AnasSarkiz/NEMA14_RP2040_V2/artifacts/v2/assembly/assembly-pcb.png

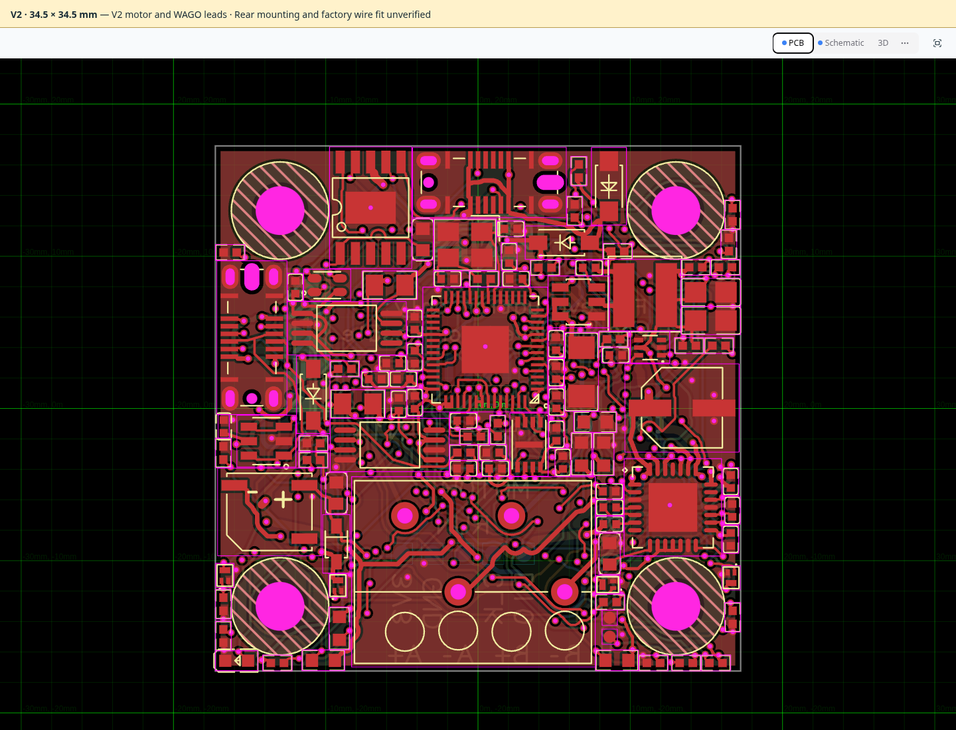
artifacts/v2/assembly/assembly-pcb.png
