AnasSarkiz/NEMA14_RP2040_V2/artifacts/v2/model-hosting/photorealistic-angled.png

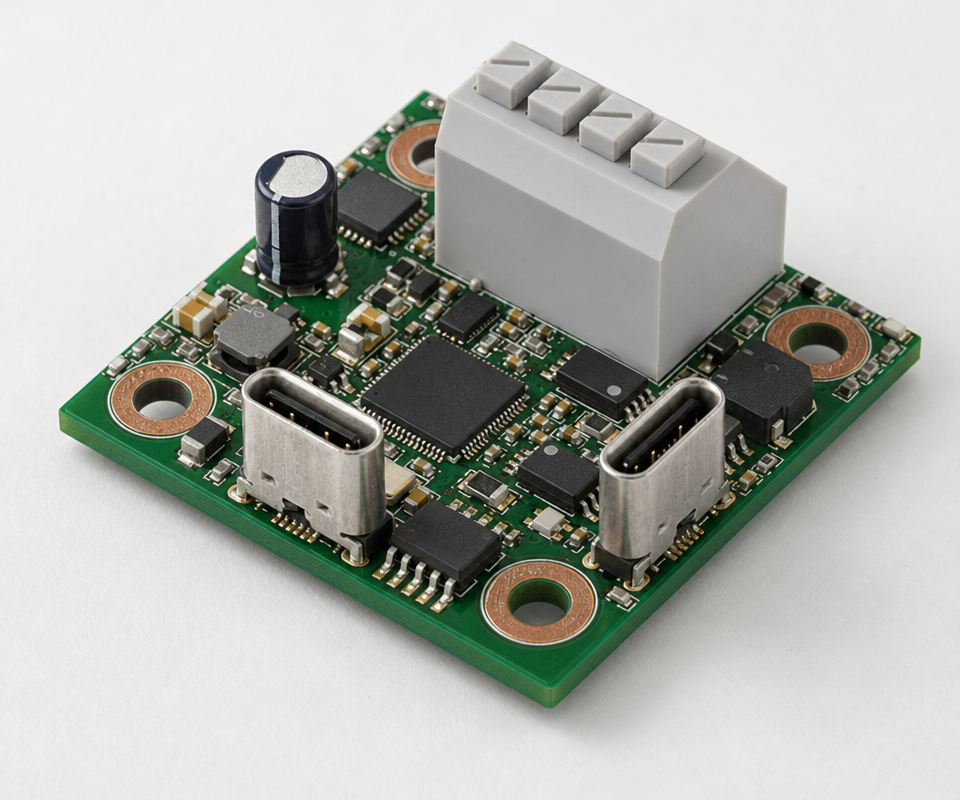
artifacts/v2/model-hosting/photorealistic-angled.png
