AnasSarkiz/NEMA14_RP2040_V2/artifacts/v2/placement.png

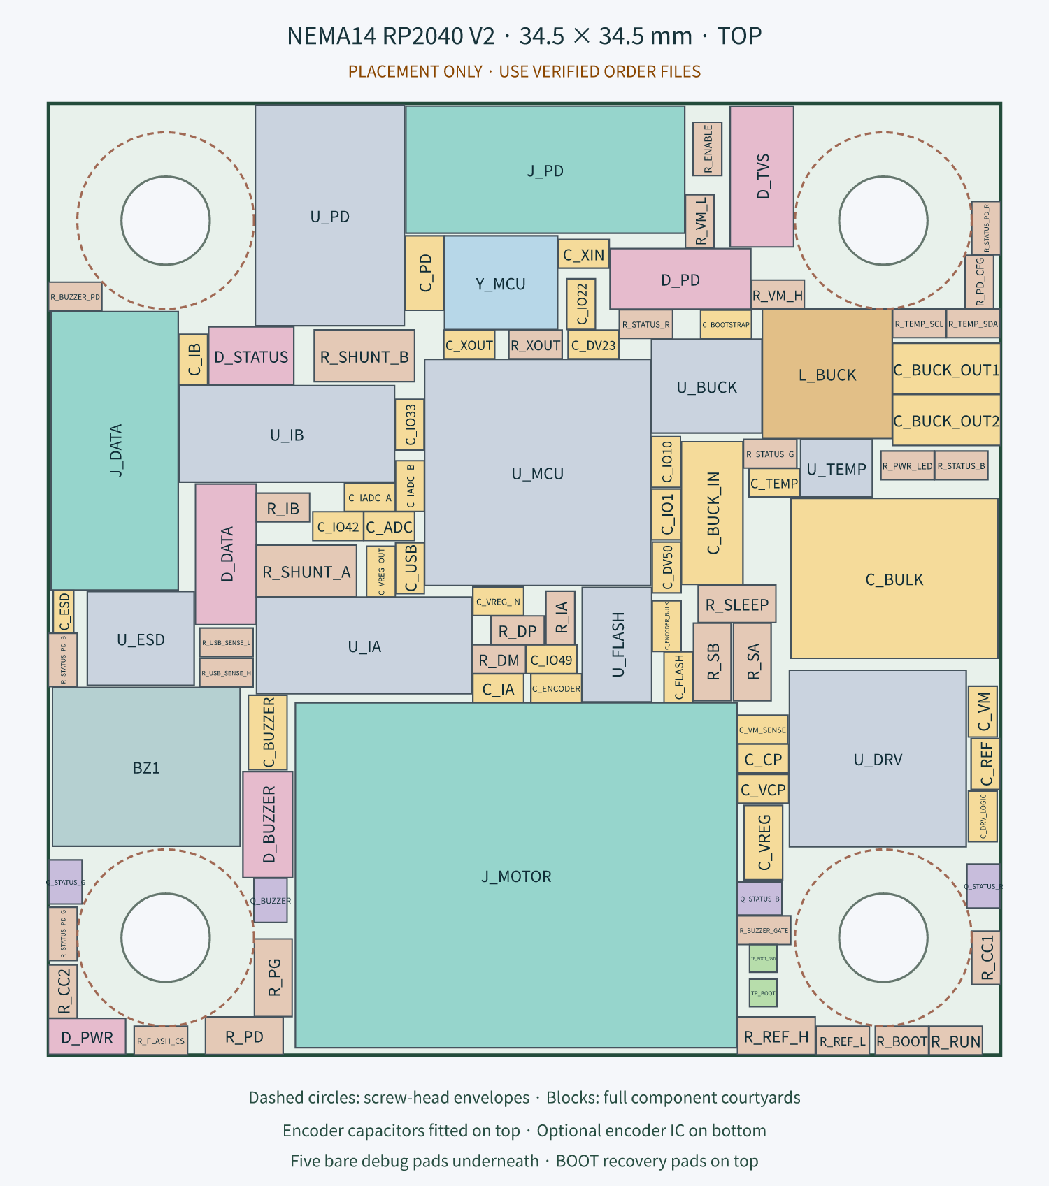
artifacts/v2/placement.png
