AnasSarkiz/NEMA14_RP2040_V2/artifacts/v2/routing/full-bottom-silkscreen.png

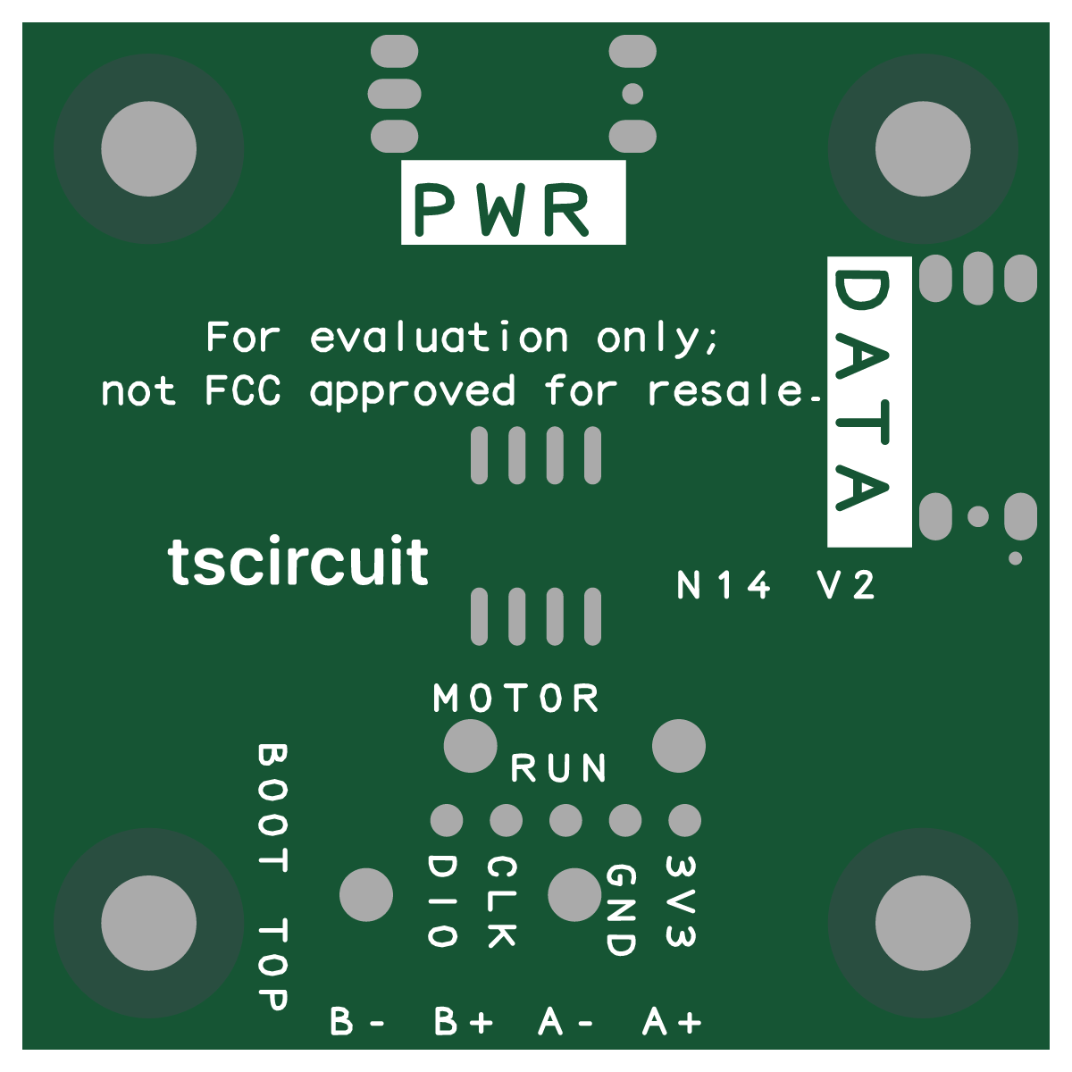
artifacts/v2/routing/full-bottom-silkscreen.png
