AnasSarkiz/NEMA14_RP2040_V2/artifacts/v2/routing/inner1.png

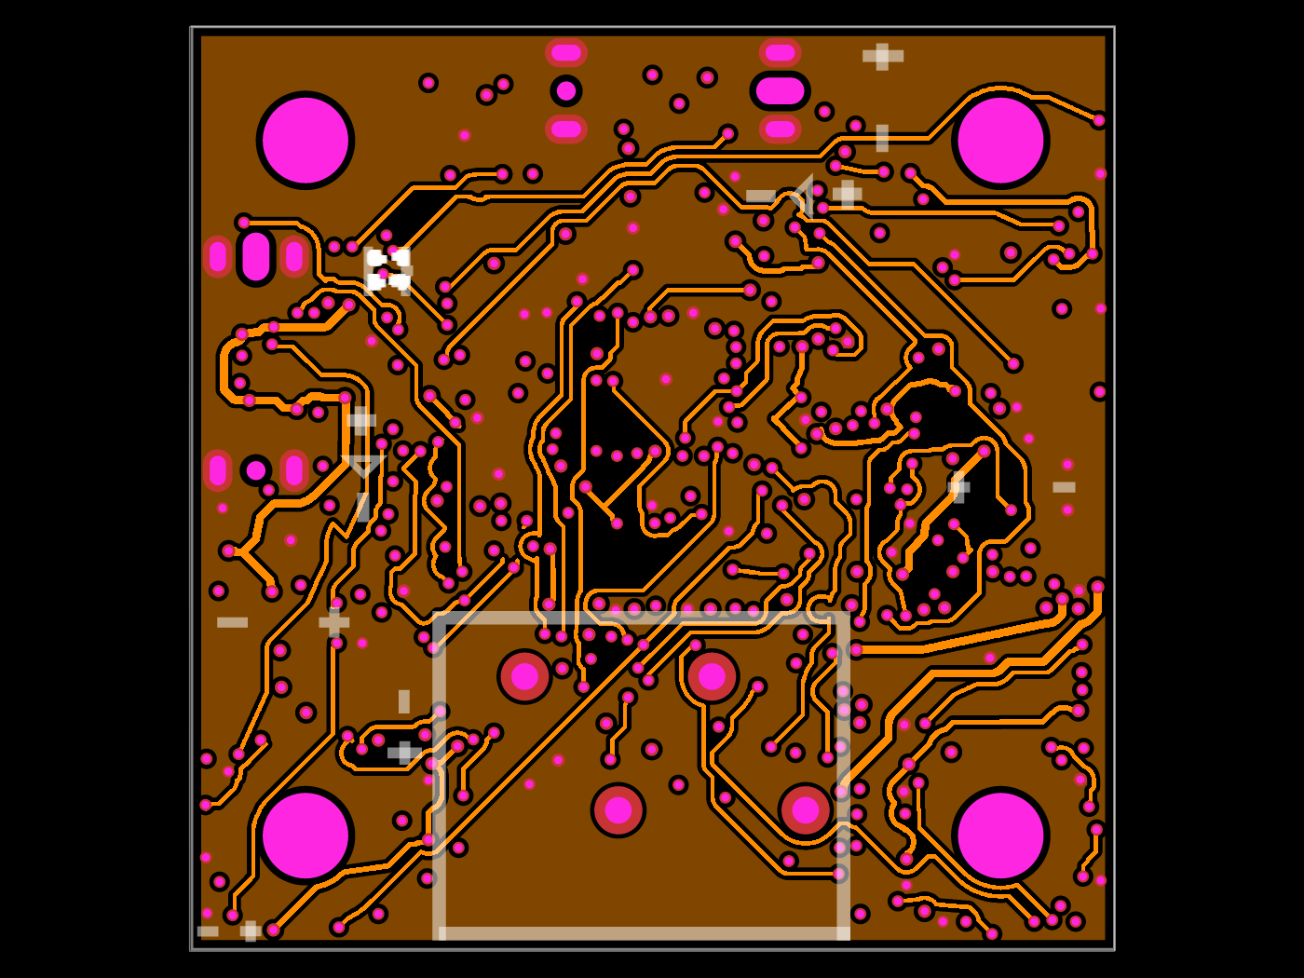
artifacts/v2/routing/inner1.png
