AnasSarkiz/NEMA14_RP2040_V2/artifacts/v2/routing/top.png

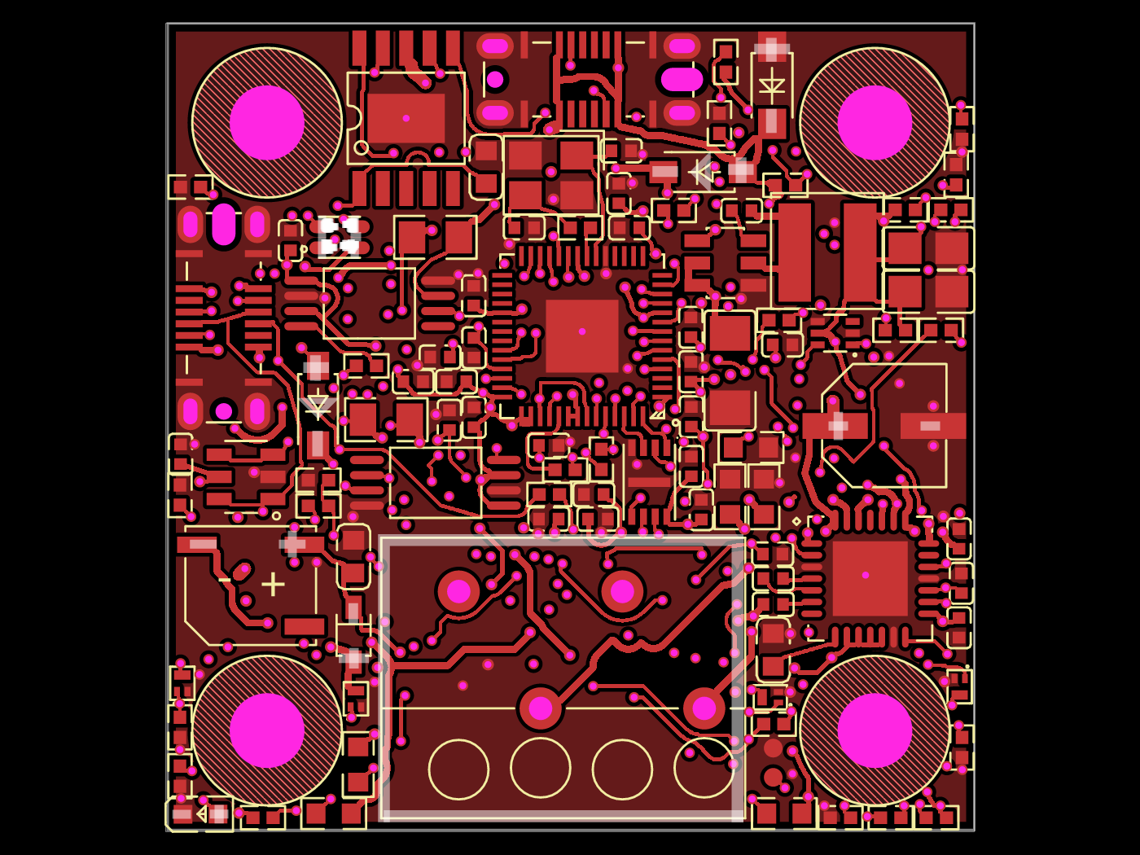
artifacts/v2/routing/top.png
