AnasSarkiz/NEMA14_RP2040_V2/artifacts/v2/routing/viewer-pcb.png

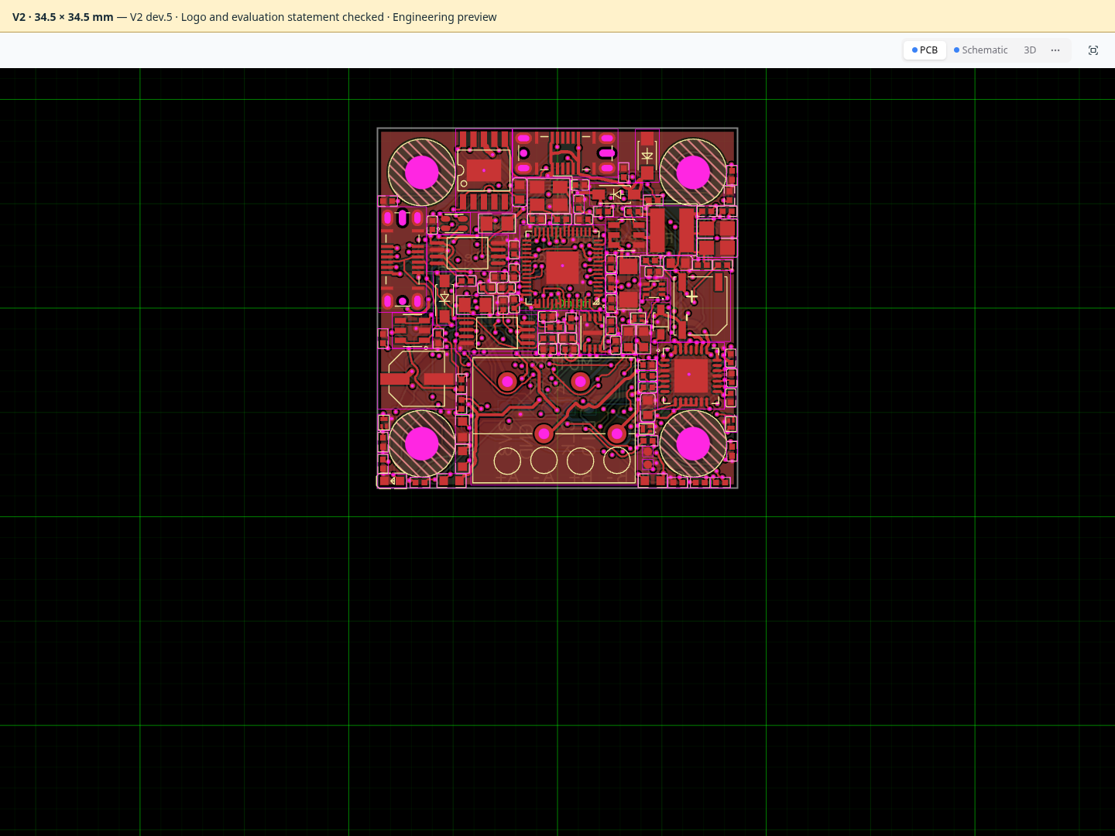
artifacts/v2/routing/viewer-pcb.png
