AnasSarkiz/NEMA14_RP2040_V2/artifacts/v2/order-review/NEMA14_RP2040_V2-BOM.csv

Comment | Designator | Footprint | LCSC Part #
USB4145-03-0070-C | J_PD,J_DATA | C5815189 | C5815189
CH224A | U_PD | C42459160 | C42459160
0603WAF0000T5E | R_PD | C21189 | C21189
CL10A105KB8NNNC | C_PD | C15849 | C15849
0603WAF1002T5E | R_PG,R_SLEEP | C25804 | C25804
RP2040 | U_MCU | C2040 | C2040
CL05B104KO5NNNC | C_IO1,C_IO10,C_IO22,C_IO33,C_IO42,C_IO49,C_DV23,C_DV50,C_USB,C_ADC,C_FLASH,C_BOOTSTRAP,C_DRV_LOGIC,C_IA,C_IB,C_TEMP,C_ENCODER,C_ESD | C1525 | C1525
CL05A105KA5NQNC | C_VREG_IN,C_VREG_OUT,C_ENCODER_BULK | C52923 | C52923
GD25Q16EEIGR | U_FLASH | C2986331 | C2986331
0402WGF1002TCE | R_FLASH_CS,R_RUN,R_VM_L,R_REF_L,R_ENABLE,R_STATUS_PD_R,R_STATUS_PD_G,R_STATUS_PD_B | C25744 | C25744
0402WGF1001TCE | R_BOOT,R_XOUT,R_STATUS_R,R_STATUS_G,R_STATUS_B | C11702 | C11702
ABM8-272-T3 | Y_MCU | C20625731 | C20625731
0402CG150J500NT | C_XIN,C_XOUT | C1548 | C1548
0402WGF270JTCE | R_DM,R_DP | C25100 | C25100
0402WGF5101TCE | R_CC1,R_CC2 | C25905 | C25905
0402WGF1003TCE | R_USB_SENSE_H,R_USB_SENSE_L,R_VM_H,R_BUZZER_PD | C25741 | C25741
CL05B103KB5NNNC | C_VM_SENSE,C_IADC_A,C_IADC_B,C_REF | C15195 | C15195
AP63203WU-7 | U_BUCK | C780769 | C780769
SRN4018-4R7M | L_BUCK | C780206 | C780206
CL31A106KBHNNNE | C_BUCK_IN | C13585 | C13585
CL21A226MAQNNNE | C_BUCK_OUT1,C_BUCK_OUT2 | C45783 | C45783
B5819W SL | D_PD,D_DATA | C8598 | C8598
A4988SETTR-T | U_DRV | C38437 | C38437
CL05B104KB5NNNC | C_CP,C_VCP,C_VM | C960916 | C960916
CL10B224KA8NNNC | C_VREG | C21120 | C21120
EEEFT1V470AR | C_BULK | C193627 | C193627
SR731JTTDR240F | R_SA,R_SB | C186557 | C186557
ERJL06KF50MV | R_SHUNT_A,R_SHUNT_B | C713441 | C713441
INA240A1PWR | U_IA,U_IB | C93965 | C93965
0402WGF1000TCE | R_IA,R_IB,R_BUZZER_GATE | C25076 | C25076
0603WAF3902T5E | R_REF_H | C23153 | C23153
250-204 | J_MOTOR | C2765063 | C2765063
USBLC6-2SC6 | U_ESD | C2687116 | C2687116
SMF18A | D_TVS | C19077512 | C19077512
TMP102AIDRLR | U_TEMP | C99269 | C99269
0402WGF4701TCE | R_TEMP_SDA,R_TEMP_SCL | C25900 | C25900
XL-1608SURC-06 | D_PWR | C965799 | C965799
0402WGF3300TCE | R_PWR_LED | C25104 | C25104
LTST-C19HE1WT | D_STATUS | C458749 | C458749
DMN2300UFB4-7B | Q_STATUS_R,Q_STATUS_G,Q_STATUS_B,Q_BUZZER | C154728 | C154728
MLT-5020 | BZ1 | C94598 | C94598
B5819WS | D_BUZZER | C64886 | C64886
CL10A106KP8NNNC | C_BUZZER | C19702 | C19702
0402WGF5602TCE | R_PD_CFG | C25796 | C25796
