AnasSarkiz/NEMA14_RP2040_V2/artifacts/v2/order-review/cam/independent-render/In1_Cu.png

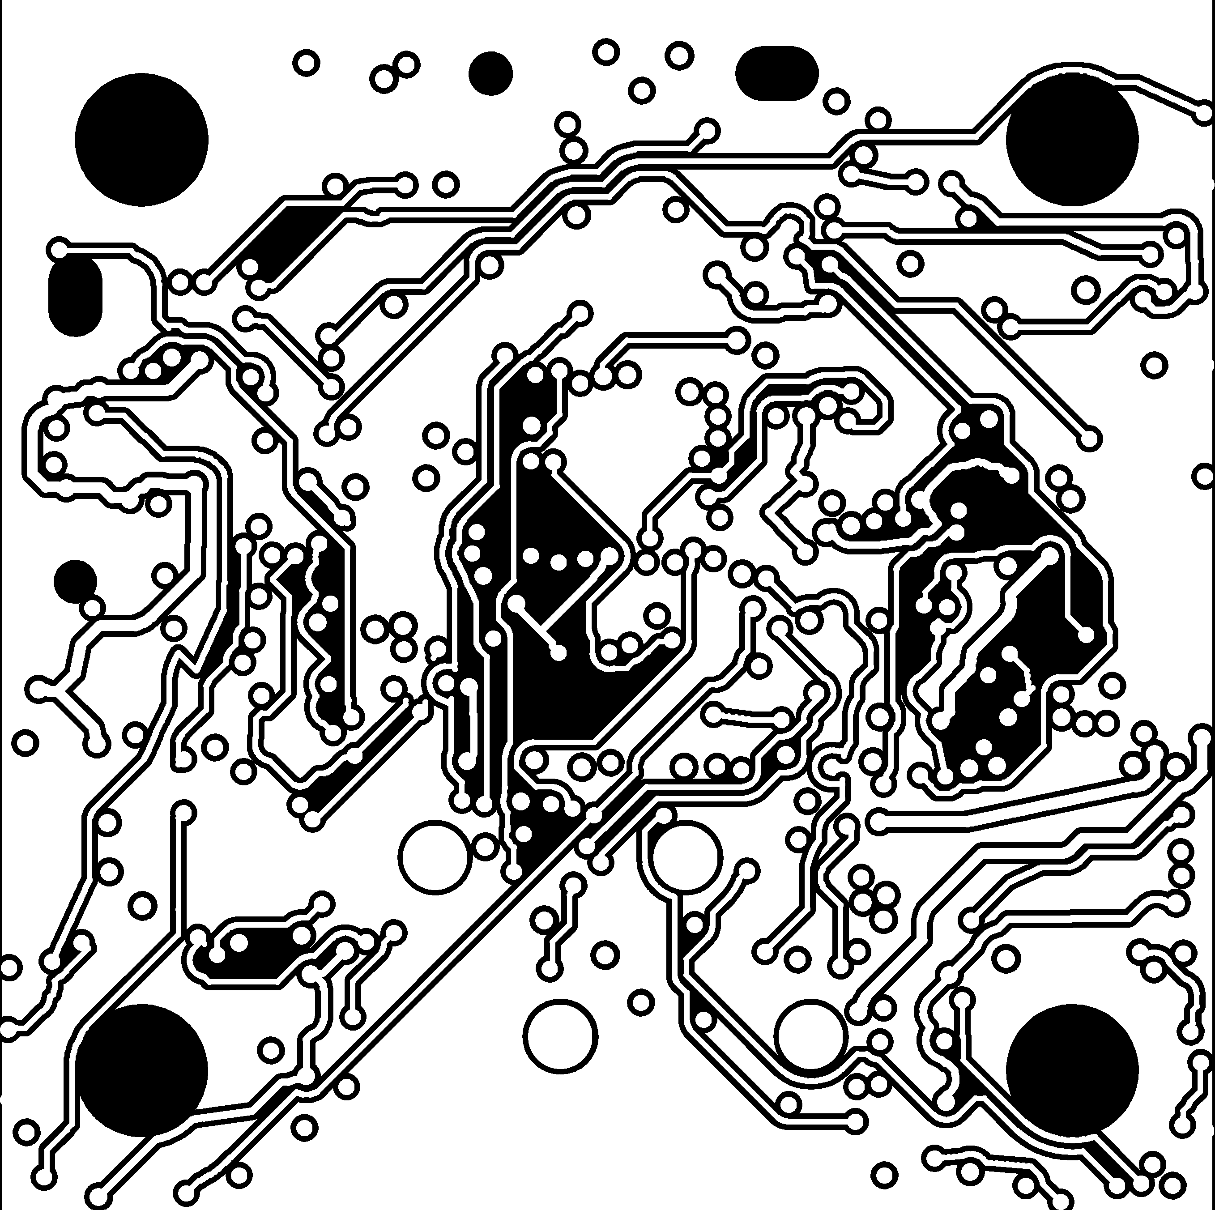
artifacts/v2/order-review/cam/independent-render/In1_Cu.png
