AnasSarkiz/NEMA14_RP2040_V2/(commit log)

2026-11-03 Preserve source advisories while checking native PCB DRC for publication
2026-11-03 Fix USB locating-slot rotation with latest tscircuit reimport and add repro
    [diagnostic-npth-not-for-order.drl, slot-rotation-probe.drl]
2026-11-03 Record verified dev.2 publication with corrected USB drill orientation
2026-11-03 Fix V2 source analysis definitions and verify unchanged routing
    [diagnostic-npth-not-for-order.drl]
2026-11-03 Make essential V2 wiring and debug legends readable
    [diagnostic-npth-not-for-order.drl]
2026-11-03 Record verified dev.4 silkscreen preview publication
2026-11-03 Restore V2 branding and add native motor with direct WAGO leads
    [diagnostic-npth-not-for-order.drl]
2026-11-03 Record verified dev.5 assembly publication and native viewer images
2026-11-03 Shorten motor leads with compact smooth bends into WAGO terminal
    [check-v2-wire-shape.py, publish-v2-tscircuit.py]
2026-11-03 Record verified dev.6 compact wire assembly publication
2026-11-03 Add separate clear-cover and motor-carrier enclosure concept
    [grip_front_left.step, grip_front_left.stl, grip_front_right.step, grip_front_right.stl, grip_left.step, grip_left.stl, grip_rear.step, grip_rear.stl]
2026-11-03 Record separate enclosure preview publication without changing approved defaults
2026-11-03 Revert enclosure concept and restore approved dev.6 project
    [grip_front_left.step, grip_front_left.stl, grip_front_right.step, grip_front_right.stl, grip_left.step, grip_left.stl, grip_rear.step, grip_rear.stl]
2026-11-03 Prepare V2 prototype CAM and fix local driver bulk placement
    [B_Cu.gbr, B_Mask.gbr, B_Paste.gbr, B_SilkScreen.gbr, Edge_Cuts.gbr, F_Cu.gbr, F_Fab.gbr, F_Mask.gbr]
2026-11-04 fix: strengthen V2 driver defaults and add local USB ESD bypass
    [B_Cu.gbr, B_Mask.gbr, Edge_Cuts.gbr, F_Cu.gbr, F_Fab.gbr, F_Mask.gbr, F_Paste.gbr, F_SilkScreen.gbr]
2026-11-04 Enlarge bottom USB port legends as knockout silkscreen
    [B_Cu.gbr, B_Mask.gbr, B_SilkScreen.gbr, Edge_Cuts.gbr, F_Cu.gbr, F_Fab.gbr, F_Mask.gbr, In1_Cu.gbr]
2026-11-04 Move bottom tscircuit wordmark into empty underside space
    [B_Cu.gbr, B_Mask.gbr, B_SilkScreen.gbr, Edge_Cuts.gbr, F_Cu.gbr, F_Fab.gbr, F_Mask.gbr, In1_Cu.gbr]
2026-11-06 fix: host V2 CAD models on verified modelcdn resources
    [B_Cu.gbr, B_Mask.gbr, Edge_Cuts.gbr, F_Cu.gbr, F_Fab.gbr, F_Mask.gbr, In1_Cu.gbr, In2_Cu.gbr]
